CRJFisher/diy-projects/projects/courtyard-nook/considerations.md

# considerations

- How to hold the roof up
  - Wooden stilt posts
    - Pros:
      - No holes in walls
      - No shared wall usage concern e.g. need to notify/clear with neighbour
    - Cons:
      - More wood to buy and construct
      - Less space inside the enclosure
      - Need to work around drainpipe for the bottom/diagonal brace connection on right side
  - Rest on wall and wall-drilled-pins
  - Mixture
    - Standalone stilts for front two and back right
    - L-shaped rests at three points in the wall: corner, then at both extents of the flat wall.
- Airflow for AC unit/Heat pump
- Depth:
  - need to fit a bike's length + (ideally) room for eventual heat pump
  - would be good to stop before drain pipe on right right side so we can have a floor connection
