CRJFisher/diy-projects/projects/bin-store/week-1/Weekend 1 Shopping List.xlsx

Weekend 1 Shopping List — Frame
B&Q Chiswick (2 Larch Drive, W4 5QL) — Call 020 8995 8028 to confirm stock before visiting
VERIFIED against diy.com and cutting plan on 11 April 2026 — FINAL pre-B&Q check
# | Product | Dimensions | Qty | Unit Price | Total | Chiswick Availability | B&Q Link / Notes
FRAME TIMBER
1 | Metsa Wood Rough Sawn Treated Whitewood Spruce 50x47mm, 2.4m (sold individually) | (L)2.4m (W)50mm (T)47mm | 8 | £7.47 |  | IN STOCK — 42 units Click + Collect | https://www.diy.com/departments/metsa-wood-rough-sawn-treated-whitewood-spruce-stick-timber-l-2-4m-w-50mm-t-47mm/1798315_BQ.prd
2 | Rough Sawn Treated Whitewood Spruce 50x47mm, 1.8m (sold individually) | (L)1.8m (W)50mm (T)47mm | 5 | £5.47 |  | IN STOCK — 88 units Click + Collect | https://www.diy.com/departments/rough-sawn-treated-whitewood-spruce-stick-timber-l-1-8m-w-50mm-t-47mm/3663602558521_BQ.prd
FRAME ROOF BATTENS (TEMPORARY STRUCTURE ONLY)
3 | Rough Sawn Treated Whitewood 50x22mm, 1.8m — roof battens (sold individually) | (L)1.8m (W)50mm (T)22mm | 4 | £4.47 |  | IN STOCK — 15 units Click + Collect | https://www.diy.com/departments/rough-sawn-treated-whitewood-stick-timber-l-1-8m-w-50mm-t-22mm/3663602558477_BQ.prd
FIXINGS
4 | Galvanised / Stainless Steel Screws Assorted box (50mm, 65mm, 75mm for frame) | Assorted lengths | 1 | 12 |  | IN STORE Standard stock item | Pick from the screws aisle — look for outdoor/galvanised. Weekend 1 needs: ~40x 75mm (joints), ~16x 65mm (braces) = ~56 total. No 50mm screws needed (noggins removed from design). A 300-500 pc assorted box covers all weekends (~200-300 total).
NOTE | X-braces: user-supplied 15x38x2400mm timber (NOT purchased from B&Q). Only 2 of 8 available sticks needed for 4 braces. 6 sticks spare.
ADDITIONAL ITEMS (BUY NOW FOR LATER WEEKENDS)
5 | Rough Sawn Treated Whitewood 50x22mm, 1.8m — shelf battens (sold individually) | (L)1.8m (W)50mm (T)22mm | 3 | 4.47 |  | IN STOCK — 15 units Click + Collect | Weekend 4 shelf battens — buy now while at B&Q. Same product as item 3.
6 | Exterior Plywood Sheet 18mm, 2440 × 1220mm | 2440mm × 1220mm × 18mm | 1 | 42 |  | CHECK STOCK May need delivery | Roof sheathing (Weekend 2) + shelf boards (Weekend 4). Full sheet covers both.
ESTIMATED TOTAL — WEEKEND 1
TRANSPORT & AVAILABILITY NOTES
2.4m TIMBER — WON'T FIT IN CAR |  | The 2.4m posts won't fit in the Honda Insight (max ~1.8m with seats down). SOLUTION: Ask B&Q to make ONE cut per stick at the post length (e.g. 1647mm). KEEP BOTH PIECES — the offcuts are exactly 750mm (depth rails). Without these offcuts you would need ~7 extra 1.8m sticks. Options if they won't cut: (1) Arrange delivery. (2) Hire a van for ~£30.
1.8m TIMBER & FIXINGS — WILL FIT |  | The 1.8m timber lengths, roof battens, and screws will all fit in the Insight with rear seats folded.
SUGGESTED APPROACH FOR TOMORROW
1. Drive to B&Q Chiswick and pick up the frame timber (items 1, 2, 3) and screws (item 4).
2. For the 2.4m posts: either have them cut to final lengths in store, or arrange separate delivery/van hire.
3. Note: Weekend 2 will cover roof sheathing (plywood), felt, and shingles.
