CRJFisher/diy-projects/week-1/weekend-1-guide.md

# Bin Store — Weekend 1: Build the Frame

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

| Measurement | Value |
|---|---|
| Total width | 1300 mm |
| Total depth | 750 mm |
| Internal depth | 650 mm (food caddy clearance) |
| Front height | 1597 mm |
| Back height | 1647 mm |
| Roof slope (back-to-front) | 50 mm fall |
| Left section width | ~860 mm (enclosed, with door) |
| Right section width | ~440 mm (open, with shelves) |

---

## Cut List

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

| Qty | Length | Description |
|-----|---|---|
| 3 | 1647 mm `[CUT:POST_BL,POST_BR,POST_BC]` | Back posts (2 corners + 1 right-section back) |
| 2 | 1597 mm `[CUT:POST_FL,POST_FR]` | Front corner posts (left + right) |
| 1 | 1503 mm `[CUT:POST_FC]` | Front centre post (sits between top & bottom rails; 1597 - 2 x 47) |
| 4 | 1206 mm `[CUT:RAIL_BACK_TOP,RAIL_BACK_BOT,RAIL_BACK_MID,RAIL_FRONT_TOP]` | Full-width rails (2 top, 1 back bottom, 1 back mid-rail at 775 mm; 1300 minus 2 x 47 mm posts) |
| 1 | 393 mm `[CUT:RAIL_FRONT_BOT_R]` | Front bottom rail -- right section only (centre post outside face to right corner post inside face; 440 section minus 47 right post) |
| 5 | 650 mm `[CUT:RAIL_DEPTH_TL,RAIL_DEPTH_TR,RAIL_DEPTH_BL,RAIL_DEPTH_BR,RAIL_DEPTH_TC]` | Depth rails (4 corner connections + 1 centre divider top) |
| 2 | 650 mm `[CUT:RAIL_MID_LEFT,RAIL_DEPTH_MC]` | Mid-rails (left wall + centre divider, at 775 mm) |
| 2 | ~1100 mm `[CUT:BRACE_BACK_1,BRACE_BACK_2]` | Back panel X-braces -- **15x38mm user-supplied** (45° both ends) |
| 2 | ~1000 mm `[CUT:BRACE_LEFT_1,BRACE_LEFT_2]` | Left panel X-braces -- **15x38mm user-supplied** (45° both ends; ~980 + ~1010, avg ~1000) |

**Fixings:** ~40x 75 mm galv screws (joints), ~16x 65 mm (braces). Roughly 56 total.

> **Noggins (optional):** can be added in Weekend 3 if cladding needs extra mid-span support.

Cut List Diagram

---

## Step 1: Build the Back Frame

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

Back Frame Face-On View

### Assembly

1. Lay all three 1647 mm `[CUT:POST_BL,POST_BR,POST_BC]` back posts flat, 50 mm face up: left corner post, centre-back post (860 mm from left), right corner post (1300 mm from left). The left-to-centre gap is ~860 mm; centre-to-right is ~440 mm
2. Butt a 1206 mm `[CUT:RAIL_BACK_TOP]` rail between the outer post tops, flush with the top ends. The rail passes over the centre-back post and is face-screwed to it -- the centre post is full height (1647 mm) and sits behind the rails, so the rails rest on its face. Pre-drill two pilot holes per joint, drive 2x 75 mm screws per side (6 screws total for this rail)
3. Repeat at the bottom. Check 90 deg with a framing square before driving screws -- tap the rail sideways to correct any racking
4. Mark all three posts at 775 mm up from the bottom rail. Fix the mid-height rail at this mark, spanning all three posts, same method (2x pilot holes, 2x 75 mm screws per side)

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

### Cross-Bracing (Upper Zone Only)

X-braces go in the **left section only** (between the left corner post and centre-back post), in the upper zone between the top rail and mid-height rail. They are surface-mounted on the **inside face** (facing the bins) -- no notches needed. This keeps the outside face flush for cladding. The right section (~440 mm) is too narrow for X-braces and will get shelves for rigidity instead.

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

### Check for Square

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

Lean the completed frame against a wall, brace side outward.

## Step 2: Build the Front Frame

The front frame is 1597 mm tall (50 mm shorter than the back to create roof slope). Unlike the back frame, the front has a **door opening** on the left (~860 mm wide) for the wheelie bin and food caddy, so it gets **no X-braces, no full-width mid-height rail, and no bottom rail across the door opening**. The centre divider post (Step 4) will define the right edge of the door opening. Refer to the **Cut List** for parts.

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

### Key Differences from the Back Frame

- **Posts are 1597 mm** (not 1647 mm) -- this creates the roof slope
- **No X-braces** -- the left section is a door opening and the right section is too narrow for meaningful bracing
- **No full-width mid-height rail** -- the left wall and right-section front get mid-rails (Step 5) but the right side wall does not (shelves will provide lateral bracing)
- **Front bottom rail is right section only (393 mm)** -- no bottom rail across the door opening so the wheelie bin can roll in and out freely
- Top rail remains **1206 mm** (full width between posts)

### Assembly

Build it flat on sawhorses:

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

> **Note:** The left section (~860 mm) will become the door opening -- keep it clear of bracing, mid-rails, and bottom rails. The right section (~440 mm) gets its bottom rail when the centre post is installed (Step 4). The centre post (Step 4) completes the front face.

Front Face -- Complete View

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

## Step 3: Connect Front & Back with Depth Rails

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

### Assembly

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

Box Frame Isometric View

Side View Showing Roof Slope

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

---

## Step 4: Install the Centre Divider

The centre divider splits the bin store into **left** (~860 mm, enclosed with door) and **right** (~440 mm, open shelves). See Cut List for timber sizes.

1. **Fit the right-section front bottom rail.** Cut the 393 mm `[CUT:RAIL_FRONT_BOT_R]` bottom rail (440 mm section width minus 47 mm right post = 393 mm, centre post outside face to right post inside face). Butt it against the inner face of the right corner post with its bottom edge flush with the post base. Fix with 2x 75 mm screws into the right corner post (pilot holes first). Leave the left end loose for now -- the centre post will sit on it next.
2. **Mark the divider position.** Measure 860 mm from the left-front post along the front top rail and mark it. This is also where the left end of the right-section bottom rail should sit.
3. **Stand the centre post.** Place the 1503 mm `[CUT:POST_FC]` post vertically at your mark, standing on top of the right-section bottom rail, 50 mm face parallel to the front edge. The post sits between the top rail and the bottom rail -- its bottom end rests on the top face of the bottom rail and its top end butts against the underside of the top rail.
4. **Fix the base.** Toe-screw 2x 75 mm screws through the post base into the bottom rail, one from each side. Pre-drill.
5. **Fix the top.** Drive 2x 75 mm screws down through the top rail into the end grain of the centre post. Pre-drill with a 5 mm bit to prevent splitting. This joint is compression-loaded (the roof pushes down), so end-grain screwing is adequate here.
6. **Fit the top depth rail.** 650 mm `[CUT:RAIL_DEPTH_TC]` rail from centre post top back to the back top rail (slopes slightly: 1597 mm front to 1647 mm back). 2x 75 mm screws at each end.
7. **Fit the mid-height depth rail.** 650 mm `[CUT:RAIL_DEPTH_MC]` rail from centre post to back frame at 775 mm height. 2x 75 mm screws at each end.
8. **Remove the temporary diagonal brace** from the front frame (if fitted in Step 2).
9. **Check plumb.** Spirit level on both faces of the centre post -- adjust until vertical before fully tightening.

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

> **No bottom rail at the door opening:** The left section (~860 mm) has no front bottom rail so the wheelie bin can roll straight in and out. The left-front corner post is braced at its base by the left-side bottom depth rail (fitted in Step 3), which is structurally sufficient.

### Plan View -- Frame After Step 4

Plan View Top-Down After Step 4

---

## Step 5: Add Remaining Mid-Height Rails

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

Fix each rail with 2x 75 mm screws at each end. The right side wall does **not** get a mid-rail -- the shelves (Weekend 4) will act as lateral bracing instead. The right section of the front face (~440 mm wide) has no mid-rail either -- the cladding is nailed directly to the centre post and right corner post, which is sufficient for such a narrow span. Check all mid-rails are level with a spirit level before fully tightening.

### Front View -- Mid-Height Rails Highlighted

Front View with Mid-Height Rails Highlighted

### Mid-height rail checklist

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

---

## Step 6: Final Quality Checks

Budget 20-30 minutes. Catching problems now saves painful disassembly later.

### 6.1 Squareness

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

### 6.2 Plumb

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

### 6.3 Level

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

### 6.4 Joint Tightness

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

### 6.5 Cross-Brace Check

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

### 6.6 Weather Protection

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

---

## Complete Frame -- What You've Built

Complete Frame 3/4 View

---

## Weekend 1 Materials Summary

### Timber (B&Q)

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

### Timber (user-supplied)

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

The remaining 6 pieces of 15x38mm are spare.

### Fixings

| Fixing | Size | Qty |
|---|---|-----|
| Galvanised screws | 75 mm | ~40 |
| Galvanised screws | 65 mm | ~16 |

### Tools

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

### NOT Needed This Weekend

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
