CRJFisher/diy-projects/(commit log)

2026-04-11 Fix rail and depth measurements to match key constraints
    Full-width rails corrected from 1300mm to 1206mm (1300 - 2x47 post
    depths). Total depth corrected from 844mm to 750mm per CLAUDE.md
    constraint (50+40+570+40+50), with internal depth 650mm and all
    depth rails updated accordingly. Left X-braces recalculated from
    ~1060mm to ~1000mm for the new depth. Validation script updated
    with new dimensional chain constraints and corrected post orientation
    in depth calculations. All 37 validation constraints pass.
2026-04-14 Remove obsolete files related to the bin store project, including assembly guide, design document, shopping list, cutting plan, noggins guide, and roof connection guide. Add OpenSCAD cheat sheet for 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
    [Bin Store Shopping List.xlsx, Weekend 1 Shopping List.xlsx]
2026-04-14 Add OpenSCAD Phase 1 model (frame + ghost bins) and fix centre post positions
    - Create parametric bin store model in bin-store-model/ with parameters.scad,
    frame.scad, bins.scad, and bin_store.scad (Phase 1: frame + ghost bins)
    - Move front centre post 47mm right (X=874) so it sits on the right bottom rail
    - Reposition back centre post inside the frame at full height (1647mm),
    one post_side in front of the back wall, with continuous back rails
    - Add sloped top depth rails matching the 50mm roof slope
    - Add edge outlines on timber for clearer cut visualisation
    - Rename post_w/post_d to post_face/post_side for clarity
    - Propagate design changes to CLAUDE.md, overview.md, validate-measureme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
    [bin_store.scad, bins.scad, frame.scad, parameters.scad]
2026-04-14 Add Phase 5: Clash Detection to OpenSCAD plan
    - Introduce a new phase for collision detection using `intersection()` to identify overlapping components.
    - Create `clash_check.scad` with toggles for checking specific pairs: bins vs frame, bins vs bins, and posts vs rails.
    - Implement a CLI automation script (`clash_check.sh`) to render checks to STL and report pass/fail based on mesh output.
    - Update openscad-plan.md to include details on clash detection methodology and automation workflow.
2026-04-14 Add Phase 2: Roof model (battens + plywood deck with 25mm overhang)
    New roof.scad with 4 sloped battens and plywood deck. Deck overhangs
    frame by 25mm on all sides to shed rain clear of the timber. Adds roof
    cuts and constraints to validate-measurements.py.
    [bin_store.scad, parameters.scad, roof.scad]
2026-04-14 Add Phase 3: Shelves with equal-clearance shelf spacing
    - Add shelves.scad with batten slats on the right section depth rails
    - Replace old centre mid and bottom-right depth rails with 6 shelf-supporting
    depth rails (3 centre + 3 right, at floor/517mm/1034mm)
    - Space shelves for equal clearance (~148mm) above each 300mm recycling box
    - Place bins on the floor (wheelie/caddy) and on shelf battens (recycling)
    - Shift recycling boxes 47mm left to align with centre post edge
    - Reorder plan phases: shelves are now Phase 3, cladding+door Phase 4
    [bin_store.scad, bins.scad, frame.scad, parameters.scad, shelves.scad]
2026-04-17 Fix X-braces: triangulated ends, Y/X offset to avoid collision, slope-aware clipping
    Replace the old x_brace cube primitive with a 2D profile system that
    clips an oversized diagonal strip against the frame opening using
    intersection(), producing angled cuts flush into corners. Each brace
    pair is offset within the timber width so they cross without colliding.
    Side panel braces now clip to a trapezoid following the roof slope.
    [frame.scad]
2026-04-18 Add Phase 4: cladding and door model with featheredge panels
    Extend the OpenSCAD bin store so the enclosure details can be reviewed alongside the frame, including the hinged door and cladding layout needed for build planning.
    [bin_store.scad, cladding.scad, door.scad, parameters.scad]
2026-04-18 Add per-board edges and alternating shade to featheredge cladding
    Derive board edges from the cross-section polygon so outlines clip to
    the panel hull automatically. Alternate board colour by row so
    individual planks are distinguishable at any viewing scale. Also
    outline the hardboard back panel.
    [cladding.scad, parameters.scad]
2026-04-20 Align door and right panel cladding edges; unify door clearance
    Add a board_z_offset parameter to featheredge_wall/front_featheredge_panel
    so the door can shift its board stack down by door_gap inside the clip
    envelope, making shadow lines land at the same global Z as the right
    front panel. Also remove door_head_clearance in favour of a uniform
    door_gap on all four sides of the door.
    [cladding.scad, door.scad, parameters.scad]
2026-04-20 Add .gitignore and .env.sample for Python workflows
    Ignore .env, __pycache__, *.pyc, and .pytest_cache. The committed
    .env.sample documents the Grist credentials required by the inventory
    scripts.
2026-04-20 Add Grist-backed inventory and cut list workflow
    Introduce scripts that extract the cut list from the OpenSCAD model,
    sync it to Grist alongside inventory and material_rules, and compute a
    shopping list from cut list minus inventory. Repo-backed snapshots in
    data/ keep the canonical state, with generated CSV/Markdown exports for
    review.
    Update openscad-plan.md and overview.md to describe the workflow: Grist
    is the day-to-day UI, the cut_list is read-only aside from the
    completed flag, and populating the shopping_list with purchase
    candidates is handled by a separate AI agent process.
    [cut_list.csv, inventory.csv]
2026-04-20 Add project-local skills for Grist sync and shopping
    Wire bin-store-sync and bin-store-shopping skills under .claude/skills/
    so the Grist inventory workflow can be driven from a single prompt.
2026-04-20 Add featheredge course height debug helper
    Parses parameters.scad and prints the Z positions of each board course,
    for sanity-checking cladding alignment without opening OpenSCAD.
2026-04-20 Switch door frame to 34mm PAR so cladding sits coplanar with right panel
    Drop door_frame_t from 38mm to 34mm (standard planed softwood from
    nominal 38mm stock). Total door thickness becomes 34 + 15 featheredge =
    49mm against a 50mm post depth, leaving a 1mm step that is well within
    the build's 2-3mm tolerance. At 38mm the door cladding was sitting 3mm
    proud of the right front panel, which was visible from oblique angles.
    [parameters.scad]
2026-04-20 Scope Grist schema to used tables and fix column-id normalization
    Removes the `projects` table and `project_id` column (this repo is single-project; other projects use separate docs) and the `material_rules` table (redundant with `inventory`). Also deletes the unused `scripts/grist_inventory/schema.py` duplicate of the JSON schema, and the `export_reports.py` / `data/exports/` pair now that Grist provides filtering and CSV export natively.
    Fixes a latent bug where Grist derives column ids from `label` text rather than the `id` we send (`cut_id` became `Cut_ID`, `length_mm` became `Length_mm_`), which broke record pushes. `GristClient.ensure_columns` now calls a new `normalize_column_ids` st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
    [cut_list.csv, inventory.csv]
2026-04-23 Raise mid-rail to 796mm to match installed back rail
    Measured 796mm from ground to underside of the installed back mid-rail;
    the left wall mid-rail will match. Shortens all three X-braces by
    ~15-16mm in the regenerated cut list. Also captures inventory and
    completed-flag state pulled from Grist during the sync.
    [parameters.scad]
2026-04-23 Add substitution candidates and harden cut-list matching
    Surfaces close-but-not-exact inventory sections when computing the bin
    store shopping list, so the agent can propose swapping a design
    parameter (e.g. 50x22 batten -> 50x18) before ordering new stock. The
    substitution review, scad edit, and regeneration loop are captured as
    Step 2.5 in the bin-store-shopping skill; forbidden parameters that
    would break the 1300mm width budget or shelf geometry are listed
    explicitly and cannot be proposed.
    Also fixes several latent bugs the review surfaced:
    - completed flag is now reset when a cut_id's dimensions drift under
    regeneration, so the checkbox can no longer point at a different
    physical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
2026-04-24 Record Weekend 1 progress and wire up shopping_list hardware/acquired fields
    - Mark 6 frame cuts completed in cut_list after Weekend 1 build.
    - Populate inventory with on-hand materials (PT posts, braces, battens, screws) and offcuts.
    - Add url + acquired columns to shopping_list schema; preserve acquired across pushes.
    - Shopping_list now carries B&Q product URLs and hand-authored hardware rows (hinges, hasp, roof board, EPDM kit); compute_shopping_list preserves hardware rows across regenerations.
    - sync_grist_tables always runs schema bootstrap so schema edits sync without --bootstrap-schema.
2026-04-24 Aggregate shopping-list rows by SKU and populate B&Q products
    Switches shopping_list from one row per unmet cut to one row per
    purchasable SKU, aggregating cuts via cuts_summary/min_stock_length_mm/
    total_linear_mm so the shopping agent can pick a single stock length
    and compute qty_needed. Updates the Grist schema, extraction, and
    SKILL.md to match, and fills in B&Q products for the 5 outstanding
    outstanding SKUs (2 ambiguous on section tolerance, 3 ready).
2026-04-24 Fix door-hinge qty_needed to reflect pack size
    hw_door_hinges linked to a 4-pack but had qty_needed=3 (treating it as
    individual hinges). Correct to 1 pack, which yields 4 hinges: 3 on the
    door plus 1 spare. Matches the SKILL.md convention that qty_needed is
    cart units of the linked listing.
2026-04-24 Swap shelf-batten SKU to non-blue 50x22 rejects
    The 50x25 Metsa Wood roof batten previously selected was a blue BS5534
    roofing batten. Switch to the Snowdon 50x22 "2x1" reject 10-pack, which
    matches the design section exactly (no batten_h drift) and is natural
    brown rather than blue.
2026-04-24 Swap door hinges to 400mm galvanised 2-pack
2026-04-24 Drop phantom shelf panels and switch plywood off marine grade
    Shelves are built from 5x50x22 battens per level, not plywood, so the
    inferred shelf_panel row in the extractor was inventing cuts that the
    OpenSCAD model never asks for. Removing it also drops the bogus 3x426
    cuts from the 18mm plywood shopping row.
    Also retire the duplicate hw_roof_board hardware row (no corresponding
    cut) and swap the two remaining plywood rows from Arranwood Marine
    BS1088 to standard WBP/exterior plywood, which is appropriate for a
    bin store under an EPDM roof. Fix the back-panel note: two 1300x824
    pieces do not nest on one 2440x1220 sheet, so the job genuinely needs
    two sheets.
2026-04-29 Add build-store-adapter skill and adapter-builder workspace
    User-invokable slash skill (/build-store-adapter [url]) that records
    sample searches on an ecommerce site with Stagehand + Playwright, then
    delegates to the store-adapter-generator subagent to classify the site
    (json_api / html_embedded_json / browser_required) and emit a
    deterministic per-site adapter under scripts/store_adapters/<slug>/.
    Generated adapters expose a fixed search() API; per-site product
    fields reflect whatever metadata the site exposes. Runtime pays no
    LLM cost — analysis is one-shot during the skill run.
    The Node bootstrap at tooling/adapter-builder/ uses Stagehand v3 +
    playwright-core, drives the LLM via OpenRo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
2026-07-23 Convert roof to gravity-rested design with corner locating blocks
    The roof now sits on top of the frame under its own weight instead of
    being screwed down. Four corner blocks fixed under the deck drop into
    the frame's top internal corners, each bearing on the side rail (locks
    left-right) and the front/back rail (locks front-back) so the roof
    cannot slide. The four support battens are retained as spacers.
    Adds roof_locating_block to the cut list (4x 70x50x47mm PT offcuts).
    [parameters.scad, roof.scad]
2026-08-11 Restructure repo for multiple DIY projects with shared inventory.
    Move bin-store under projects/, generalize Grist sync/shopping around --project, and scaffold courtyard-nook so leftover stock can be reserved across builds.
    [Weekend 1 Shopping List.xlsx, bin_store.scad, bins.scad, cladding.scad, door.scad, frame.scad, parameters.scad, roof.scad]
2026-08-11 Enhance Courtyard Nook documentation and model files
    Updated CLAUDE.md to clarify design constraints and added site envelope notes. Introduced new OpenSCAD files: parameters.scad for dimension definitions and walls.scad for wall modeling. Added courtyard_nook.scad for the main assembly. Removed placeholder .gitkeep file from the model directory.
    [courtyard_nook.scad, parameters.scad, walls.scad]
2026-08-11 Refine courtyard nook model parameters and wall definitions
    Updated parameters.scad to clarify dimensions and wall heights, including adjustments for the nook's left and right walls. Enhanced walls.scad to reflect the new wall configurations and colors, ensuring accurate representation of the nook and surrounding structures. Improved comments for better understanding of the model's design intent.
    [parameters.scad, walls.scad]
2026-08-21 Model the neighbour's wall and gutter, and derive the roof pitch from them
    The back of the nook is not one flat wall: brick runs 820mm from the left
    corner, then the neighbour's house wall interrupts it and rises past the
    brick. Their gutter runs along their eaves away from the courtyard, so only
    its near end reaches back over the nook, 50mm past the back wall plane.
    That gutter end and the bathroom extractor are the two obstructions the roof
    must pass under, and because they sit at different depths they fix the
    steepest buildable roof plane: 13.7 degrees falling toward the courtyard
    opening, 1773mm at the opening rising to 2260mm at the back wall. shed.scad
    draws that plane. The extractor'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
    [courtyard_nook.scad, parameters.scad, shed.scad, site.scad, walls.scad]
2026-08-21 Isolate the roof in the bin store preview
    Comment out every assembly except roof() so the gravity-rested roof can be
    viewed on its own. Scratch state - revert before working on the frame.
    [bin_store.scad]
2026-08-22 Add considerations for roof support and airflow in courtyard nook
    Introduced a new considerations.md file outlining various options for roof support, including wooden stilt posts and wall-drilled pins, along with their pros and cons. Added notes on airflow requirements for the AC unit/heat pump and specified depth considerations for accommodating a bike and heat pump while avoiding drain pipe interference.
